al3xxli/Piranha-Clock/docs/TEETH.md

# Fourteen flat removable teeth

U01–U08 fit C01's upper sockets; L01–L06 fit C02's lower sockets. The curved fang silhouette is retained in a flat 3 mm plate. Print the broad face down. Each root is 5 × 3 mm with 7 mm engagement, a flexing center slit and 6.1 mm-wide snap shoulders. The production entry is 5.4 × 3.4 mm, opening into a 6.4 mm retention pocket. No adhesive is specified.

Test one tooth in T03 before the jaws. Its one/two/three-dot sockets have 0.15/0.20/0.25 mm clearance per side; two dots match the production jaw. The root should compress during insertion and recover inside the pocket. This is a design intent, not a measured retention force. If it cracks, jams or pulls out too easily, adjust the root/socket settings and reprint the sample before the jaws. PETG is a starting material for the flexing roots; brittle materials need particular care.

Use the assembled model's exploded-teeth layer to identify the socket positions. IDs increase with the angle around each rim from +X toward -X; upper angles are 5,25,45,65,115,135,155,175 degrees, lower 15,35,55,125,145,165. The roots are rectangular and should not be twisted. Push near the base of the fang along the socket axis. Do not press the sharp tip. For replacement, pull at the base along the same axis while supporting the lip; the inward barb taper permits removal, but repeated removal durability is untested.

The teeth on Beds 07 and 08 nest inside the empty pot rings to reduce bed count. Keep tooth roots free of paint and leave their slits open. No printed part is impact-proof; the separate teeth are replaceable if damaged. These flat roots are not compatible with V5's round D-shaped sockets.
