al3xxli/Piranha-Clock/images/left_cheek_closed.png

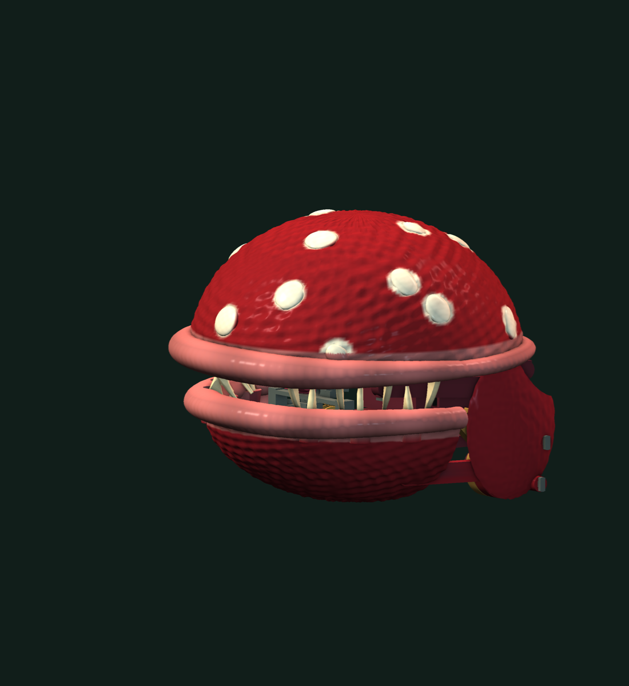
images/left_cheek_closed.png
