al3xxli/Piranha-Clock/images/left_cheek_open.png

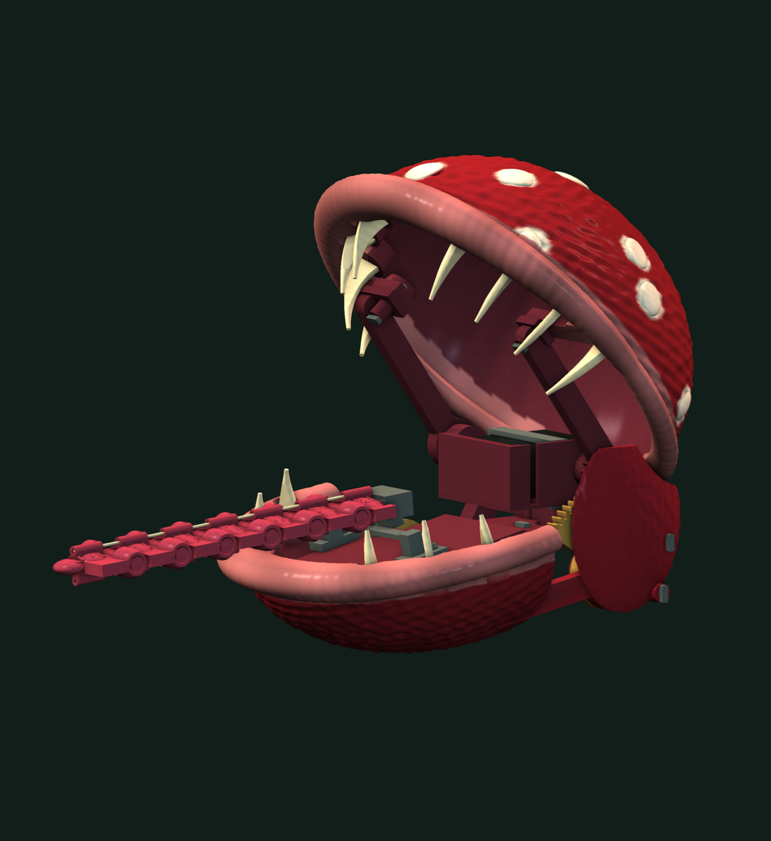
images/left_cheek_open.png
