al3xxli/Piranha-Clock/images/mechanism_curled.png

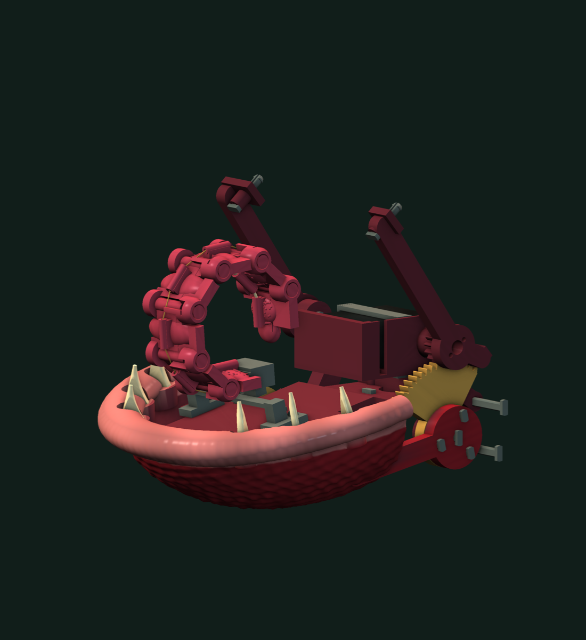
images/mechanism_curled.png
