al3xxli/Piranha-Clock/images/tongue_detail.png

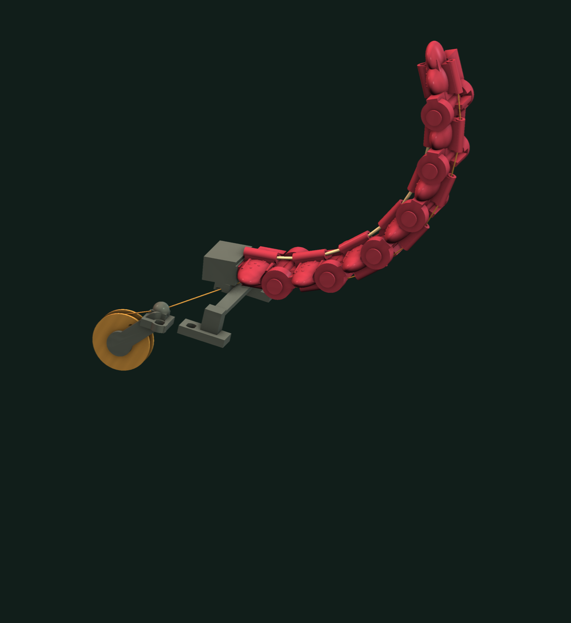
images/tongue_detail.png
