al3xxli/Piranha-Clock/docs/BOM.md

# V6 materials and components

| Item | Quantity / starting provision |
|---|---|
| MG995 positional servo | 1, user-owned; jaw drive |
| MG90S positional servo | 1, user-owned; tongue drum |
| Arduino UNO R4 Minima | 1 |
| Optional DS3231 RTC breakout | 1 for time retention across power loss; default uses the built-in RTC |
| Optional TM1637 four-digit display | 1; check PCB fit and enable USE_DISPLAY |
| Regulated servo supply | Separate 4.8 V supply, sized for both servos' measured peak current |
| USB power/cable and signal leads | As needed; common ground |
| Optional passive piezo element + 1 kOhm resistor | 1 each; enable USE_BUZZER |
| Nonstretch braided line | 0.4–0.6 mm, at least 500 mm before trimming |
| Soft round elastic | Nominal 0.8 mm; six ~80 mm pieces plus spare |
| Cardboard / curved foamcore | 98 mm-high pot sleeve, plus seam; see cut guide |
| Cardboard floor / optional top infill and shims | User-cut sheet stock |
| Filament | Mechanical parts with flex-capable roots/clips; inspect slicer for actual quantity |
| Optional base ballast | Insulated, secured inside base after checking tipping stability |

Printed components include 28 split push pins, two case clips, 14 flat teeth, two replaceable spline inserts, 12 alternate spline trial inserts and fit coupons. The tongue is one captive assembly of seven sections. Only one fitting insert is installed per servo; unused F-series trials are spares/test pieces. No user-installed screw, nut, washer, metal hinge pin, purchased horn, glue or cable tie is part of V6 assembly.

The pot's continuous wall is sheet material. A printed open tray holds electronics and an open spoke support carries the stem; these are retained to provide a load path. Thin cardboard may need doubled layers and shims. Test rigidity and resistance to tipping with the head fully open and the tongue out before running the mechanism.
