al3xxli/Piranha-Clock/print_beds/Bed_07_Bottom_Rim_and_Upper_Teeth.stl

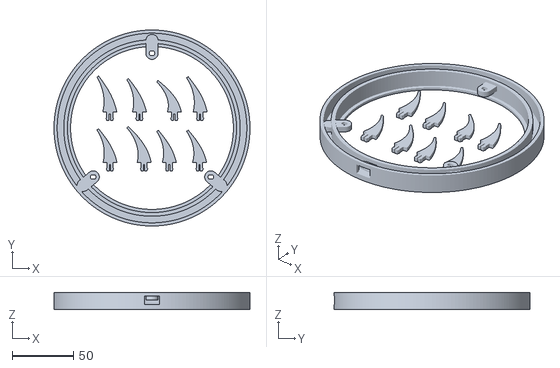
[picture p8: CAD file, 2026-10-25]
print_beds/Bed_07_Bottom_Rim_and_Upper_Teeth.stl
160.0 x 160.0 x 14.0
