al3xxli/Piranha-Clock/print_beds/Bed_03_Stem_and_Mounts.stl

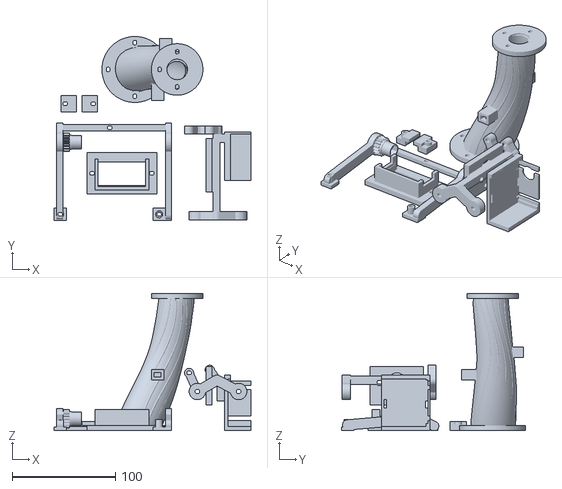
[picture p9: CAD file, 2026-10-25]
print_beds/Bed_03_Stem_and_Mounts.stl
191.0 x 178.5 x 133.2
