al3xxli/Piranha-Clock/print_beds/D_Bed_06_Upper_Head.stl

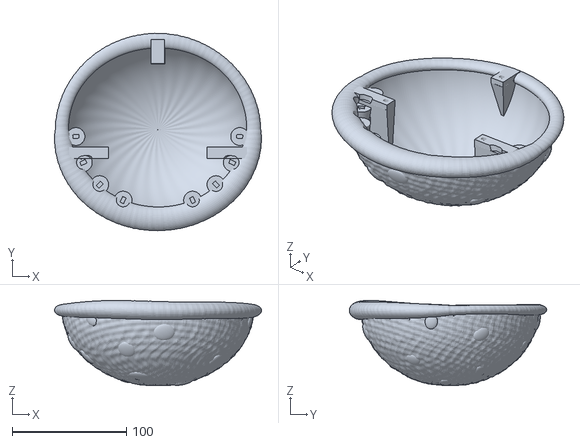
[picture p10: CAD file, 2026-10-25]
print_beds/D_Bed_06_Upper_Head.stl
181.3 x 173.0 x 74.6
