al3xxli/Piranha-Clock/print_beds/Bed_01_Cheek_PushPins.stl

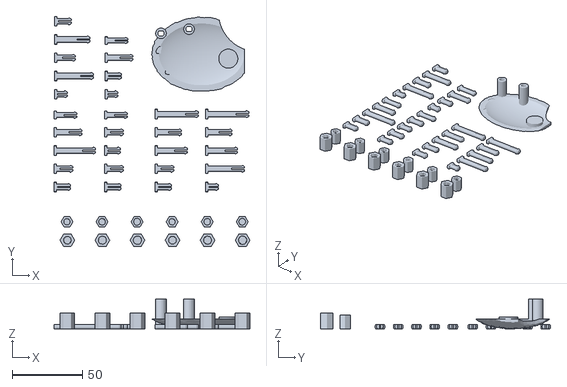
[picture p11: CAD file, 2026-10-25]
print_beds/Bed_01_Cheek_PushPins.stl
139.8 x 164.2 x 21.1
