al3xxli/Piranha-Clock/print_beds/D_Bed_05_Lower_Jaw.stl

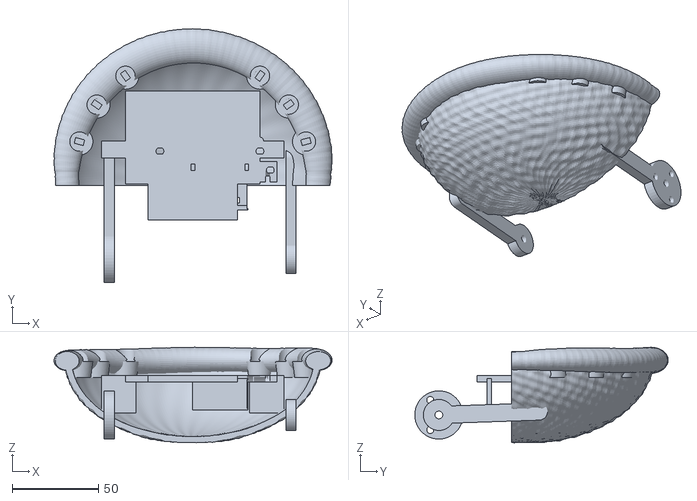
[picture p12: CAD file, 2026-10-25]
print_beds/D_Bed_05_Lower_Jaw.stl
161.2 x 147.0 x 55.4
