al3xxli/Piranha-Clock/print_beds/Bed_08_Top_Rim_and_Lower_Teeth.stl

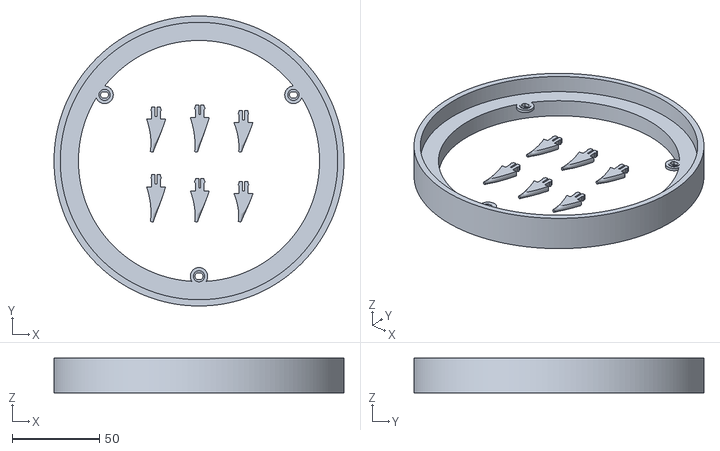
[picture p13: CAD file, 2026-10-25]
print_beds/Bed_08_Top_Rim_and_Lower_Teeth.stl
166.0 x 166.0 x 20.0
