al3xxli/Piranha-Clock/print_beds/Bed_04_Top_Support_and_Leaves.stl

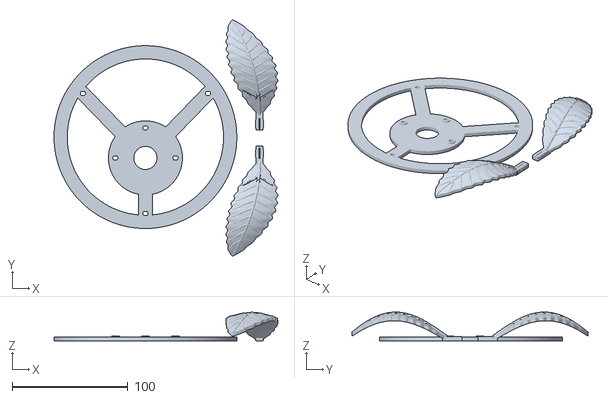
[picture p14: CAD file, 2026-10-25]
print_beds/Bed_04_Top_Support_and_Leaves.stl
193.6 x 204.4 x 25.0
