al3xxli/Piranha-Clock/print_beds/Bed_02_PIP_Tongue_and_Drive.stl

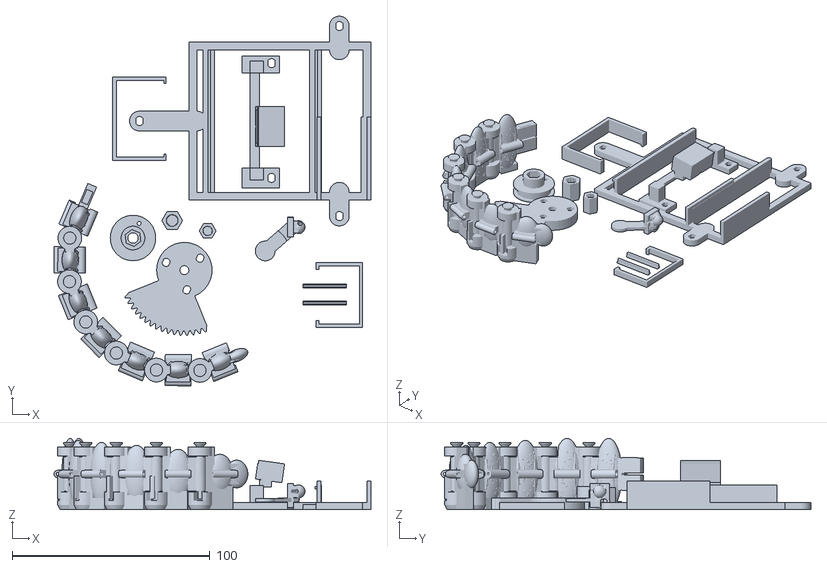
[picture p15: CAD file, 2026-10-25]
print_beds/Bed_02_PIP_Tongue_and_Drive.stl
160.2 x 186.8 x 36.0
