al3xxli/Piranha-Clock/print_beds/D_Bed_00_Fit_Samples.stl

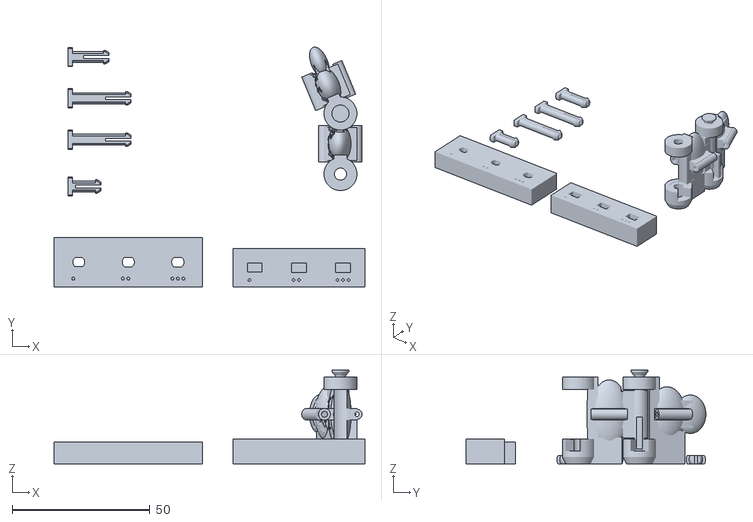
[picture p16: CAD file, 2026-10-25]
print_beds/D_Bed_00_Fit_Samples.stl
113.0 x 87.1 x 34.0
