al3xxli/Piranha-Clock/print_beds/Bed_03_FIX_Stem_and_Mounts.stl

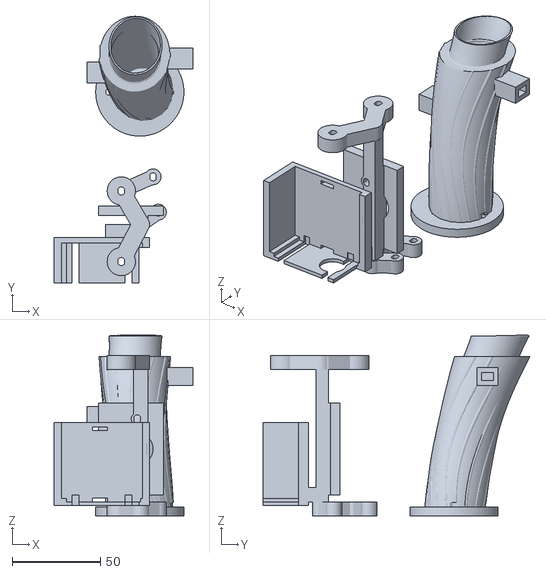
[picture p17: CAD file, 2026-10-25]
print_beds/Bed_03_FIX_Stem_and_Mounts.stl
78.5 x 151.0 x 102.5
