al3xxli/Piranha-Clock/(list of files, cad)

Other CAD files:
cad/Piranha_Clock_V6_Press_Fit.3dm
cad/Piranha_Clock_V6_Print_Beds.3dm
