al3xxli/Piranha-Clock/images/assembled_curled.png

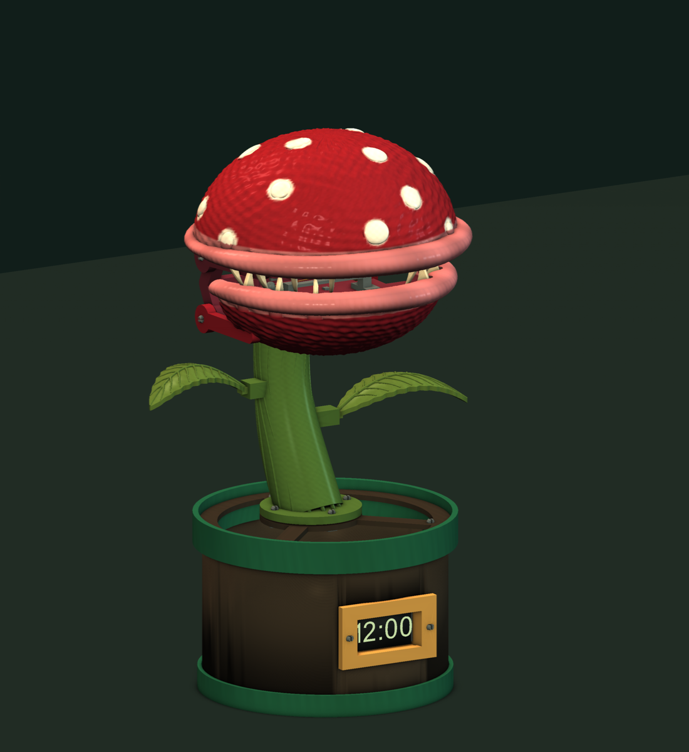
images/assembled_curled.png
