al3xxli/Piranha-Clock/images/assembled_extended.png

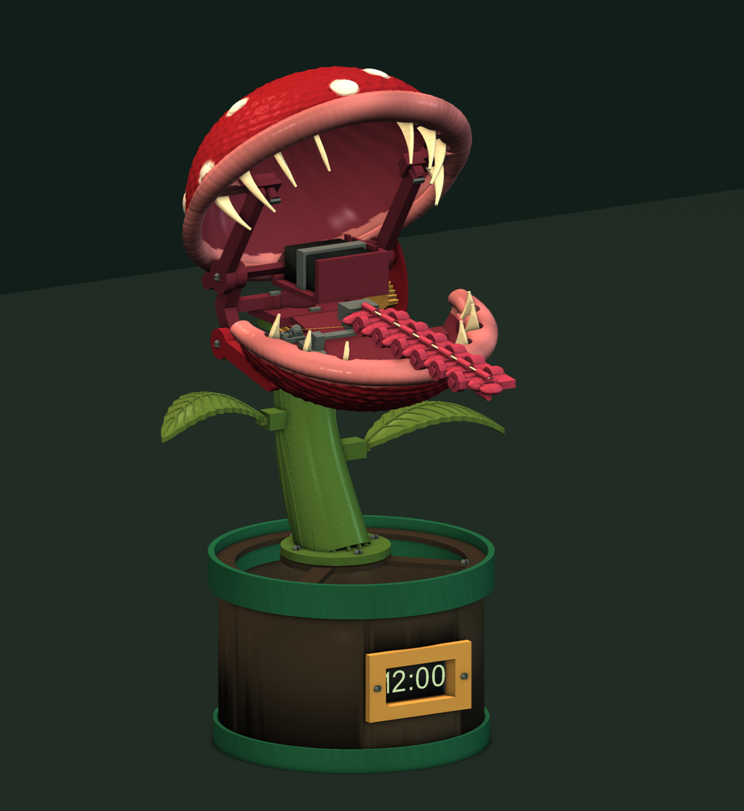
images/assembled_extended.png
