al3xxli/Piranha-Clock/images/print_beds_isometric.png

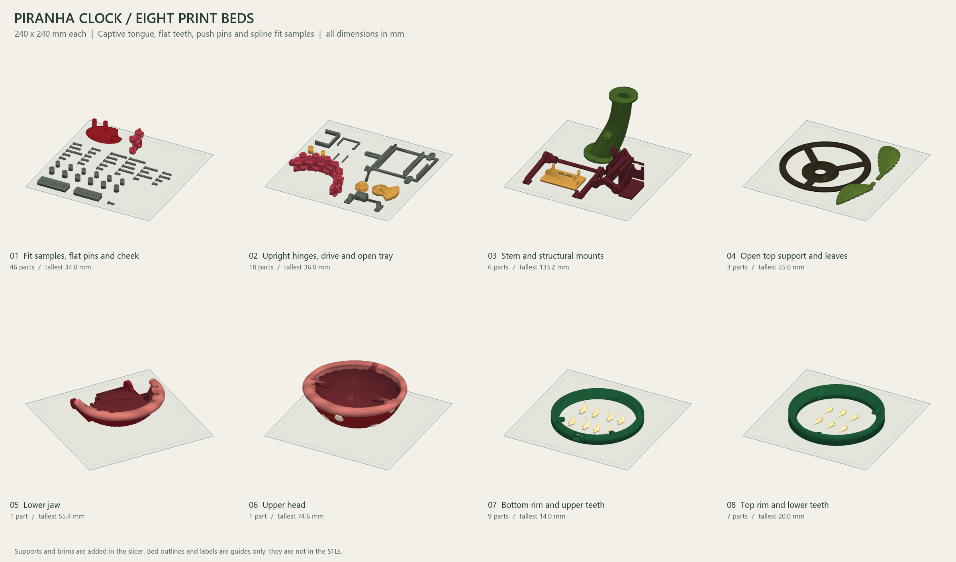
images/print_beds_isometric.png
